tylertaewook/project-orbitron/Final Deliverables/orbitron-paper.pdf

# Intuitive Control Algorithm Development of 4WIS/4WID Using A SpaceMouse

Introduction | Development Procedure

# Prototype: Orbitron

# Steering Modes in Our Algorithm

# Conclusion

# Results & Discussion

Ackerman Steering | Spinning

AFRS
(Active Front and Rear Steering) Crab Steering
Conventional Steering | 4WIS/4WID

While the conventional steering system only involves Ackerman Steering, 4WIS/4WID is capable of three different steering modes: AFRS, Crab Steering, and Spinning. Our algorithm supports all three steering modes and allows us to simultaneously control all four wheels without any danger of movement conflicts. We do so by computing both the wheel’s direction and speed based on the wheel’s angular velocity during a turn. This prevents any conflicts between the signals that can result in a vehicle slipping.

We built a prototype that uses a 4WIS/4WID system to evaluate the funcHonality of our algorithm. Powered by Arduino, each wheel has a 12V DC motor and a mulH-rotaHonal servo motor which are controllable from MathemaHca with xBee wireless modules.

# Algorithm Setup

Our algorithm’s main job is to translate the six variables from the SpaceMouse to eight variables, each of which represents either angle or speed of a wheel. The algorithm is responsible for calculaHng variable transformaHons and records the sets of Hmestamped variables in a CSV file. We then use a serial regulator, a C# applicaHon that we’ve developed, to deliver the set of variables at a proper Hme without overfeeding data to the prototype.

Rectangular Path

Circular Path

Spinning

First experiment was to use the crab steering mode to make the vehicle move in a rectangular path without turning it. All four wheels always turned together in the corner of a rectangle and the speed was constant for all four wheels.

Second experiment was to use AFRS mode to drive the vehicle in a circular path, but facing the center at all times. Each wheel was fixed in an angle that is tangent to the turning direction, and different speed values were given for each wheels to account for the different distance from the center.

Third experiment was to use the Spinning mode to rotate the vehicle with zero radius. It is similar to the circular path experiment, but the center of curvature was set to the center of the vehicle rather than outside of the vehicle. As a result, all wheels was set to be tangent to the turning circle and speed was constant while turning.

Crab Steering
+
AFRS

Crab Steering

Spinning

4WIS/4WIS (4 Wheel Independent Steering/Driving) is a steering system for a four-wheeled vehicle that allows for separate speed and direcHon controls for each wheel. These controls enable more versaHle moHon for vehicles that needs to navigate Hght spaces, such as a wheelchair narrow subway cars.

In the leX scenario, a 2 wheel steering system (2WS) requires much more space (colored purple) to get to the desHnaHon than a 4WIS/4WID (colored brown).

4WIS/4WID

2WS 4WIS/4WID

3dconnexion’s SpaceMouse™ involves 3Dconnexion's patented 6 degrees of freedom (6DoF) sensor that is specifically designed for manipulaHng digital content or camera posiHons in industry-leading CAD applicaHons. SpaceMouse converts an input from the user to a set of six numbers that range from −1 to +1. For example, one output created during the experiment was: { 0.234, −0.112, 0.066, −0.422, −0.208, 0.112 }.

SpaceMouse

Crab Steering

AFRS

In the beginning, we developed a 3D simulaHon with MathemaHca to visualize how
different steering modes actually work. Later on, we developed all simulaHons in 2D so that
we calculate each wheel’s speed and angle values more accurately.

Crab steering is a special type of active four-wheel steering that operates by steering all wheels in the same direction and at the same angle.

We developed an algorithm, implemented in MathemaHca, that allows intuiHve control of a 4WIS/4WID vehicle. With the assumpHon that all moHons are circular moHons, our algorithm abstracts away the complexity and allows for a full realizaHon of the vehicle’s capabiliHes without any special training on the operator’s part. 4WIS/4WID system is a promising steering mechanism that can be applied in various vehicles/robots that require maneuverability in narrow spaces and more efficient control.

AFRS mechanism involves front and rear wheels turning independently for smaller turning radius and better cornering stability. In this steering mode, rear wheels change the way a vehicle turns based on driving parameters. Each wheel’s velocity is computed as the tangential velocity of a circle.

Our algorithm uses the Crab steering mode whenever the user slides the SpaceMouse on the plane. In this specific example, when the mouse is facing upper right corner, all four wheels are angled in the direcHon the mouse is poinHng at. All four wheels have the same speed which is computed as the tangenHal velocity of a circle with a very large radius.

In these example, straight motion and curving motion are accomplished simultaneously. When twisting and shifting the mouse occurs at the same time, the vehicle can perform more complicated motion, such as moving forward with a gradually decreasing turning radius.

Spinning
Also known as the Zero Turn mode, Spinning is the motion of a vehicle rotating with zero radius. It is easily accomplished by turning all wheels perpendicular to the center diagonal line and turning the wheels in the same direction.

When one of the two budons on the side of the SpaceMouse is pressed, the vehicle rotates in the respecHve direcHon. As shown in the screenshots above, the vehicle turns in a clockwise direcHon when the right budon is pressed, and the vehicle rotates in a counterclockwise direcHon when leX budon is pressed.

https://goo.gl/images/yWSNtb

*All images/figures taken by the author unless otherwise noted https://goo.gl/images/jbnCfY

hdps://goo.gl/images/jENKSp

A PWM (Pulse Width Modulation) value between 0 and 255 controls the speed of each wheel, and a PWM value between 700 and 2300 controls the servo angle.

- ∝

1
/

The twisting motion of the SpaceMouse is responsible for changing the radius of the vehicle’s curvature. The core of our algorithm is that it considers every motion as a circular motion and computes each wheel’s velocity and angle tangent to that circle. The radius of curvature (-) is calculated by the equation shown above, and the angle value (/) is controlled with the twisting motion of the mouse.

When the mouse is twisted clockwise, / is increased, resulting in a larger curvature radius. When the mouse is twisted counterclockwise, / is decreased, resulting in a smaller curvature radius. Negative / will make the circle move in the other side of the vehicle.

This principle also applies to straight motion in scenarios such as Crab Steering mode. Continuously twisting the mouse counterclockwise will make / very small, leading the turning radius to be almost infinite. At this point, the vehicle’s motion will be considered to be a straight motion.

## Tae wook (Tyler) Kim, Kent School’20 – kimt20@kent-school.edu

Lockheed Martin Physical Sciences Awards --- Finalist - Physical Sciences Senior High - CSF Medallion

## Computer Science Awards --- Senior High Finalist - Medallion

Collins Aerospace Engineering Awards --- Finalist - Engineering High School - CSF Medallion
United Technologies Corporation Awards --- $500 in UTC Common Stock, Plaque, Backpack, and Annual Report

## IEEE, Connecticut Section --- $250 Honors Award -Senior

Robotics And Beyond ---For Excellence in Engineering Design- $200 for Robotics And Beyond Academy in July

## Barker Mohandas Awards for Transportation Research --- $200 Cash & Plaque for Excellence
