tylertaewook/project-orbitron/Data/mathematica-gui.png

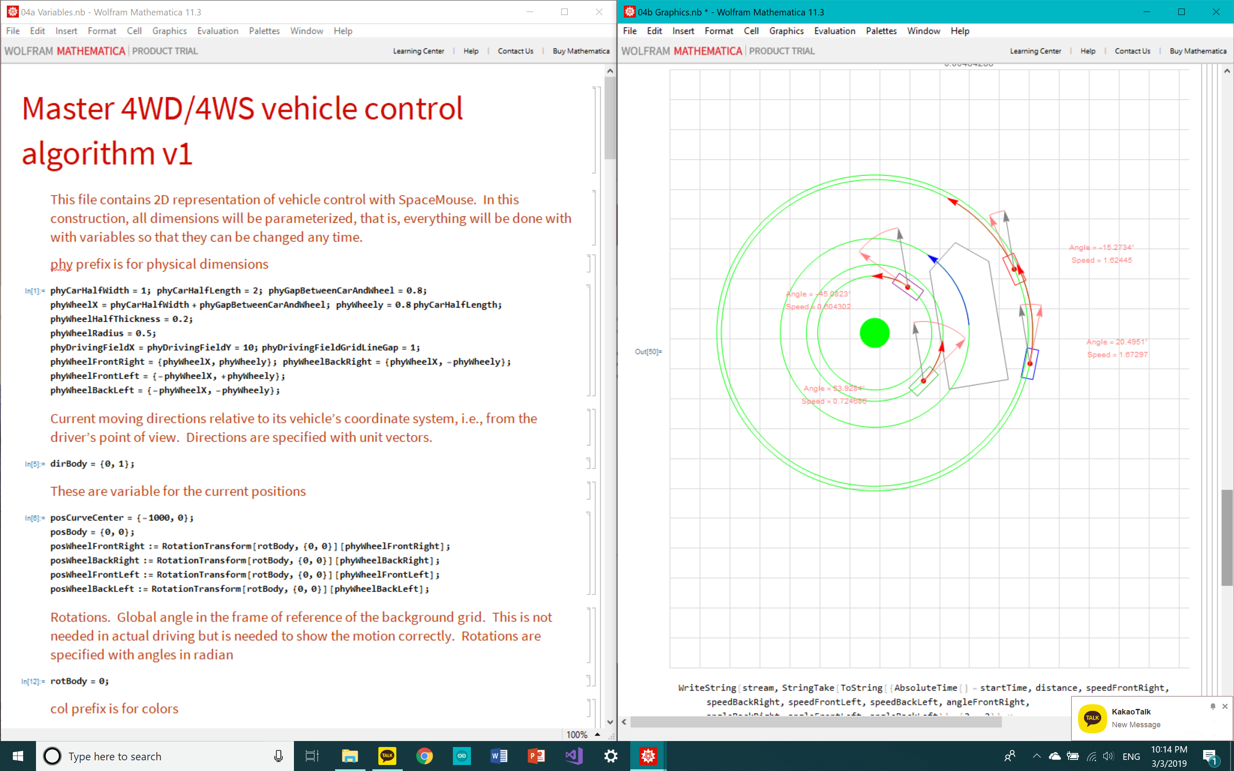
Data/mathematica-gui.png
