tylertaewook/project-orbitron/Parts List.pdf

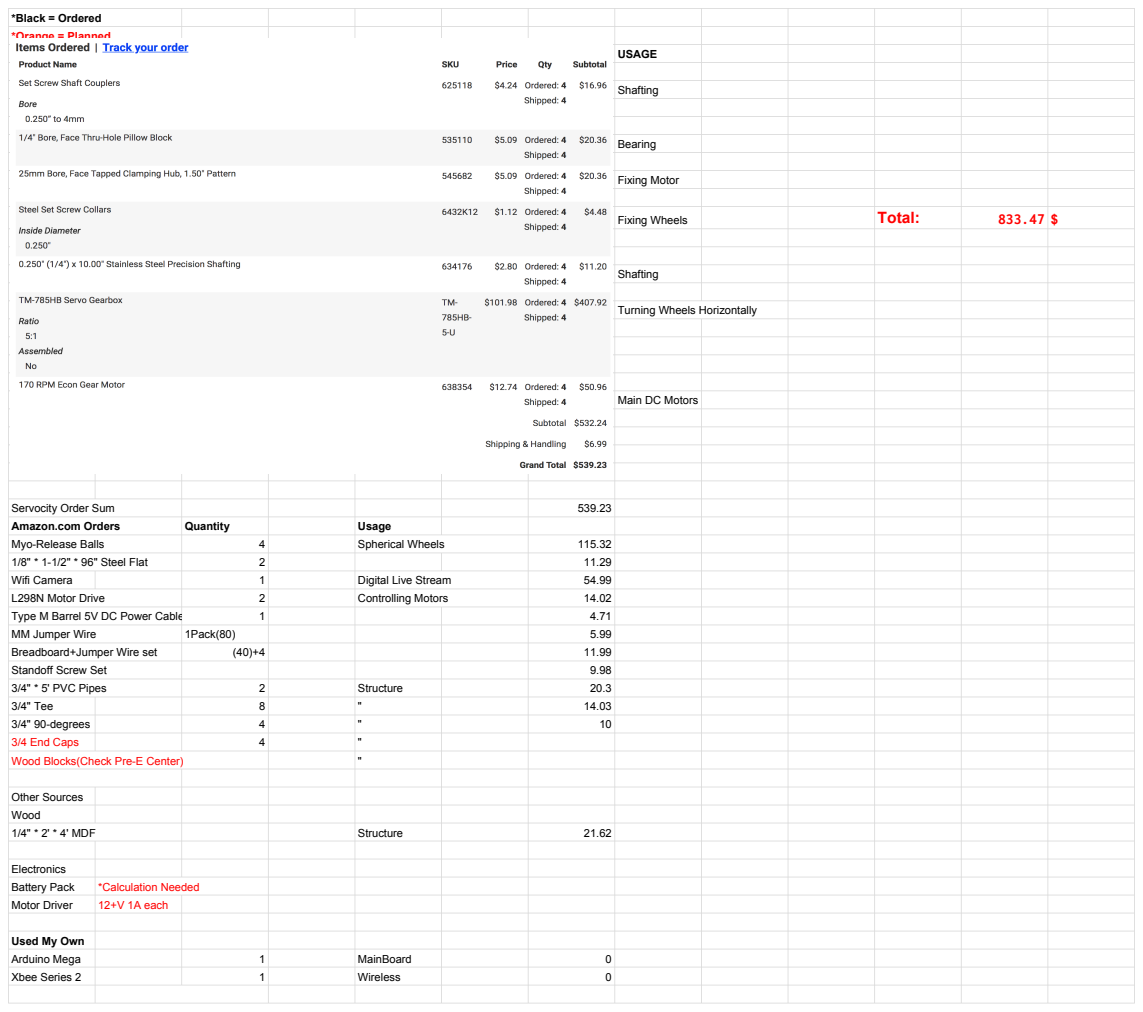
[picture p16: page 1]
*Black = Ordered; *Orange = Planned; USAGE; Total 539.23; *Ordered with Educational Discount(15%); Shafting; Bearing; Fixing Motor; Fixing Wheels; Total:; Servocity Order Sum; Amazon.com Orders; Quantity; Usage; Myo-Release Balls; Spherical Wheels; 1/8" * 1-1/2" * 96" Steel Flat; 11.29 Wifi Camera; Digital Live Stream; L298N Motor Drive; Controlling Motors; Type M Barrel 5V DC Power Cable; MM Jumper Wire; 1Pack(80); Breadboard+Jumper Wire set; Standoff Screw Set; 3/4" * 5' PVC Pipes; Structure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

servocity.com Orders

Turning Wheels Horizontally

Main DC Motors

Other Sources Wood

Used My Own
