tylertaewook/project-orbitron/Orbitron Drawings.pdf

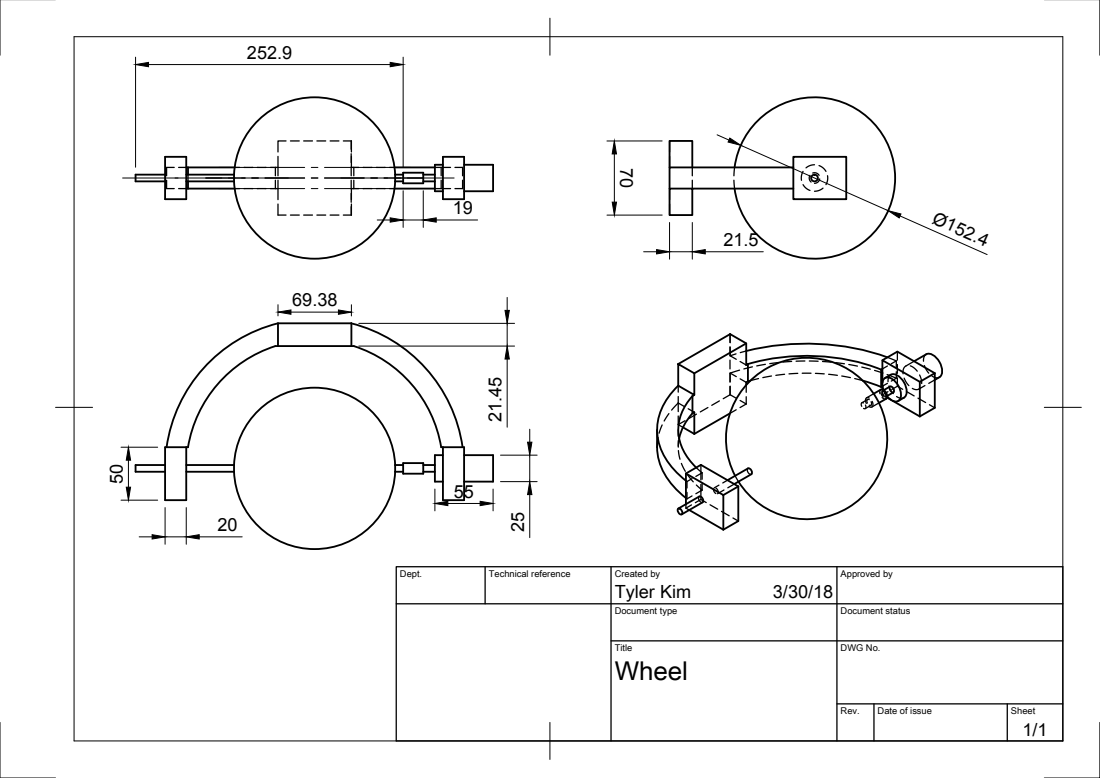
[picture p17: page 1]

Dept. | Technical reference | Created by Tyler Kim 3/30/18 | Approved by

Document type | Document status

Title Wheel | DWG No.

Rev. | Date of issue | Sheet

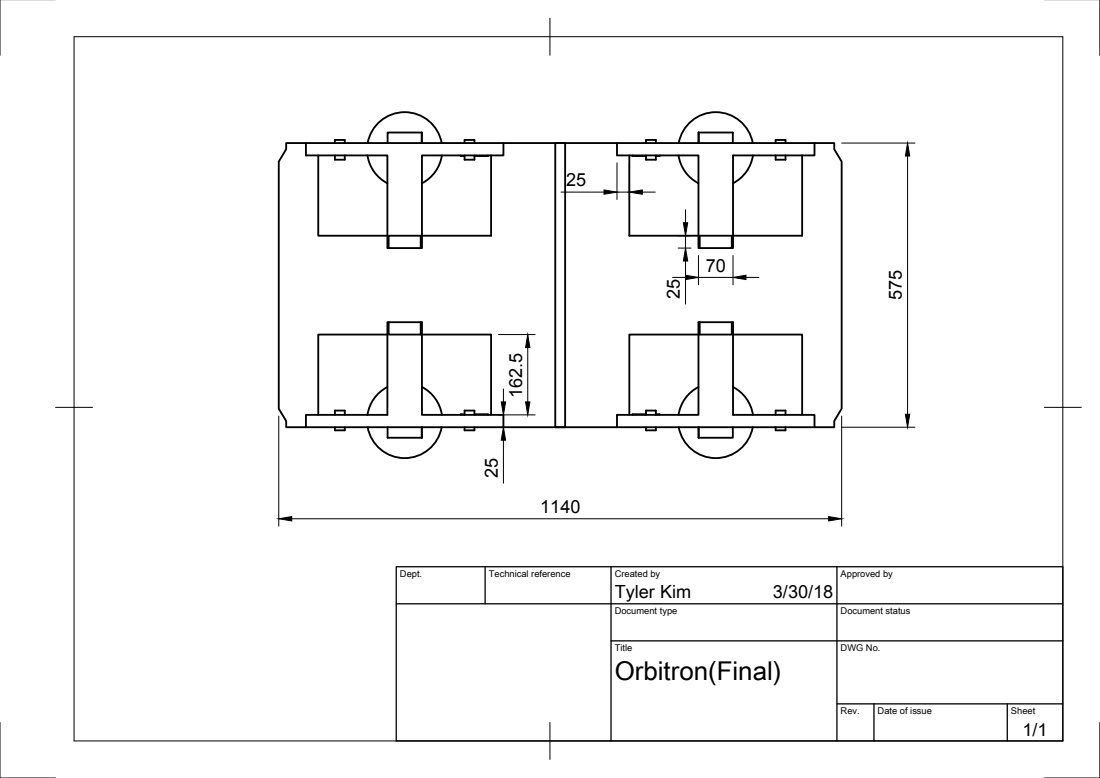
[picture p18: page 2]

Dept. | Technical reference | Created by Tyler Kim 3/30/18 | Approved by

Document type | Document status

Title Orbitron(Final) | DWG No.

Rev. | Date of issue | Sheet

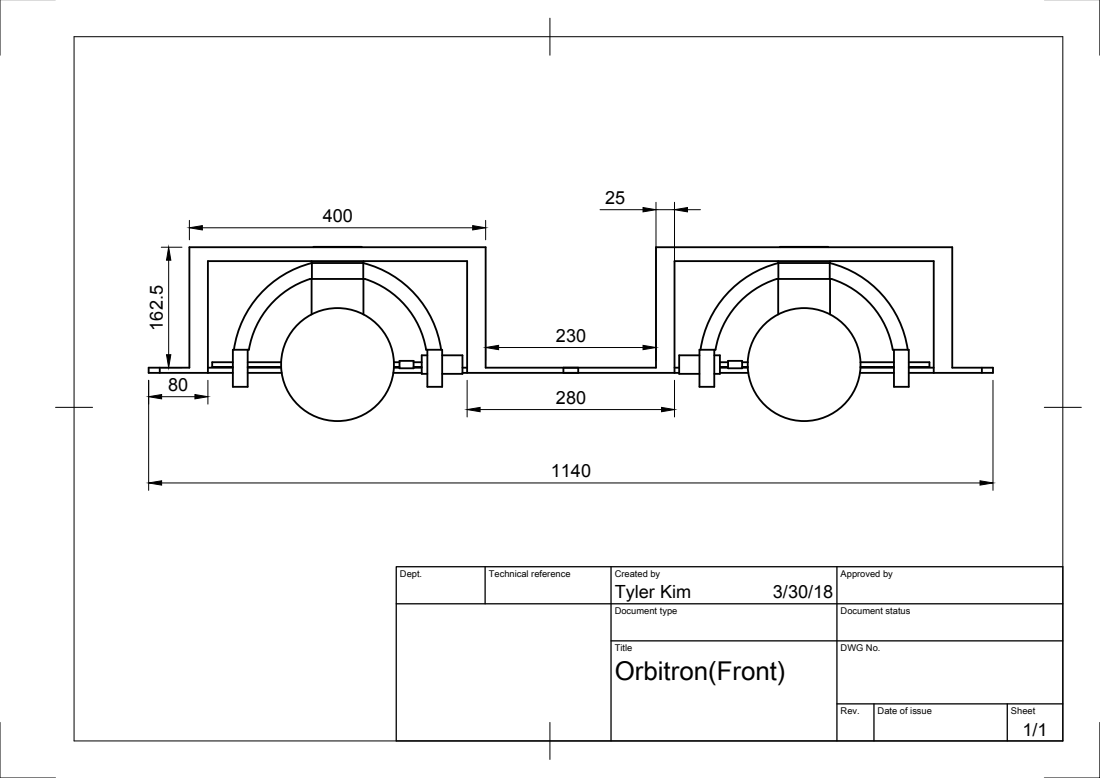
[picture p19: page 3]

Dept. | Technical reference | Created by Tyler Kim 3/30/18 | Approved by

Document type | Document status

Title Orbitron(Front) | DWG No.

Rev. | Date of issue | Sheet

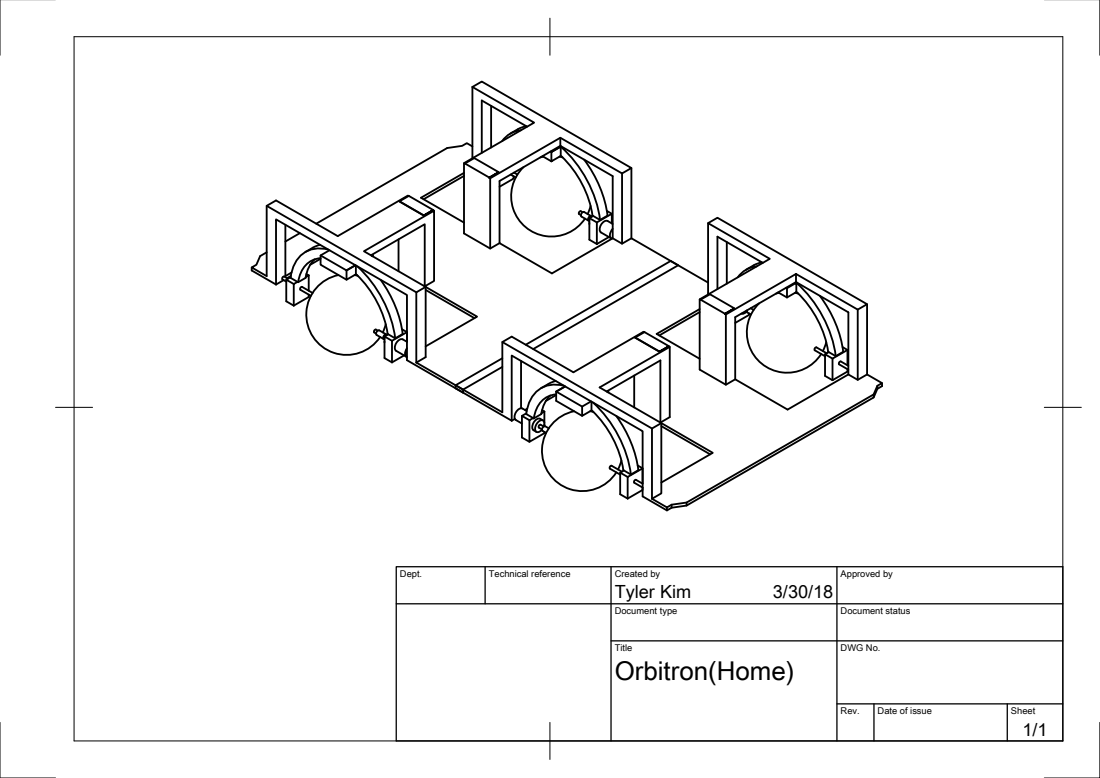
[picture p20: page 4]

Dept. | Technical reference | Created by Tyler Kim 3/30/18 | Approved by

Document type | Document status

Title Orbitron(Home) | DWG No.

Rev. | Date of issue | Sheet

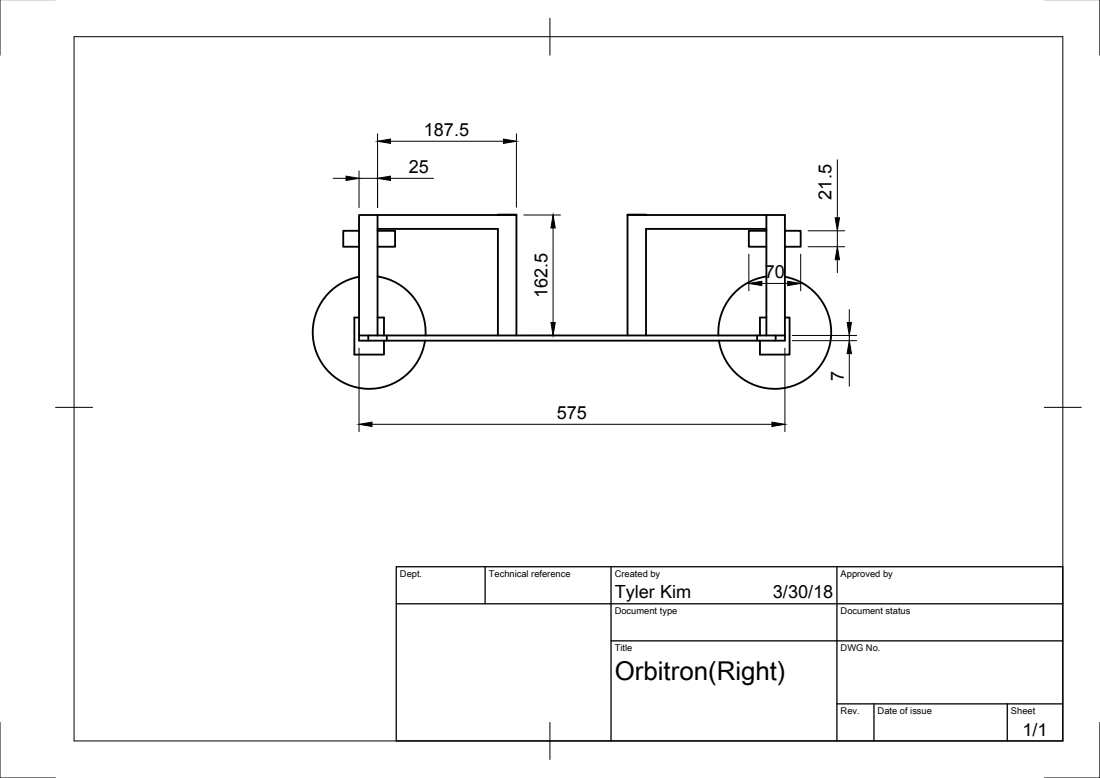
[picture p21: page 5]

Dept. | Technical reference | Created by Tyler Kim 3/30/18 | Approved by

Document type | Document status

Title Orbitron(Right) | DWG No.

Rev. | Date of issue | Sheet

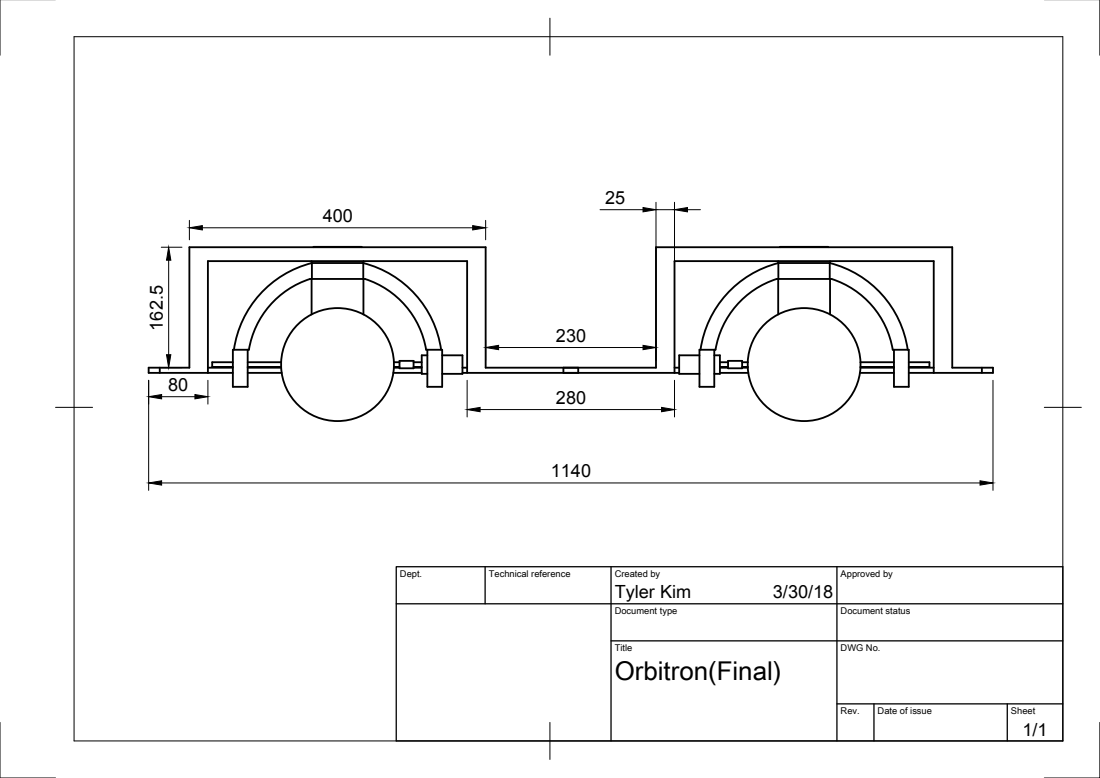
[picture p22: page 6]

Dept. | Technical reference | Created by Tyler Kim 3/30/18 | Approved by

Document type | Document status

Title Orbitron(Final) | DWG No.

Rev. | Date of issue | Sheet
