tylertaewook/project-orbitron/(commit log)

2020-10-04 Added all files from local path
    [Rectangular.csv, circular.csv, spin.csv]
2020-10-06 Added Orbitron Test Arduino code
2020-10-07 added images1
    [Rectangular.csv, circular.csv, spin.csv]
